longdesu/Smart-Irrigation-System/IMG/capacitive2.jpg

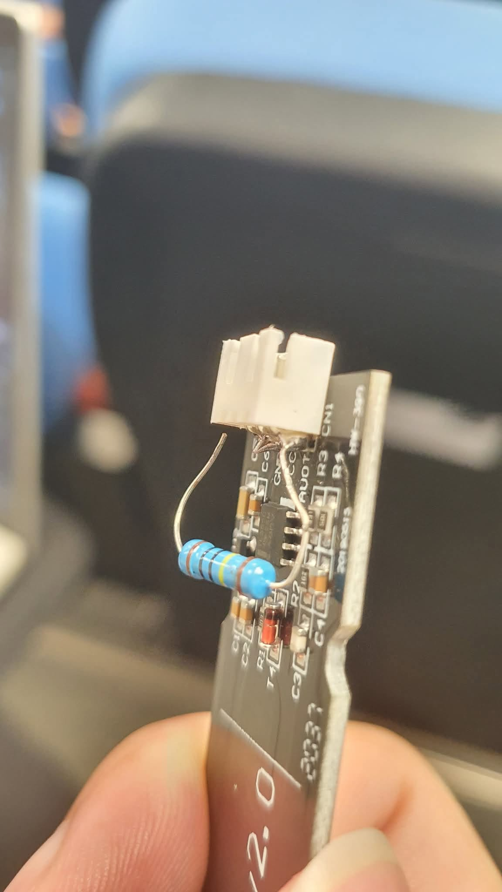
IMG/capacitive2.jpg
